LWitter/Arduino_Nanoject/IMG_2895.jpeg

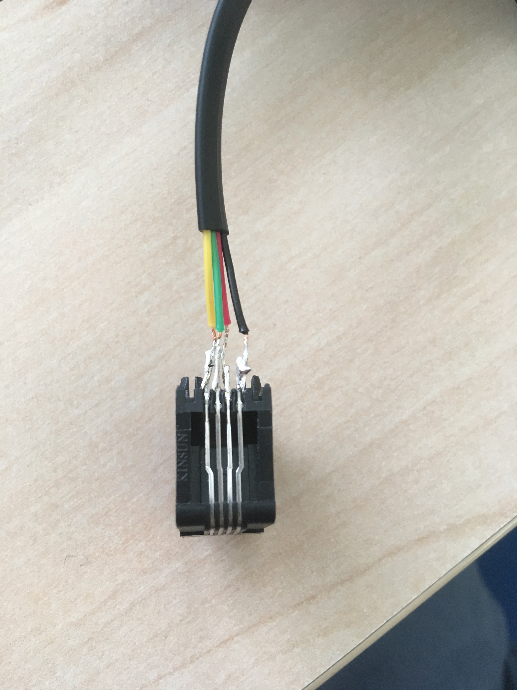
IMG_2895.jpeg
