LWitter/Arduino_Nanoject/IMG_2896.jpeg

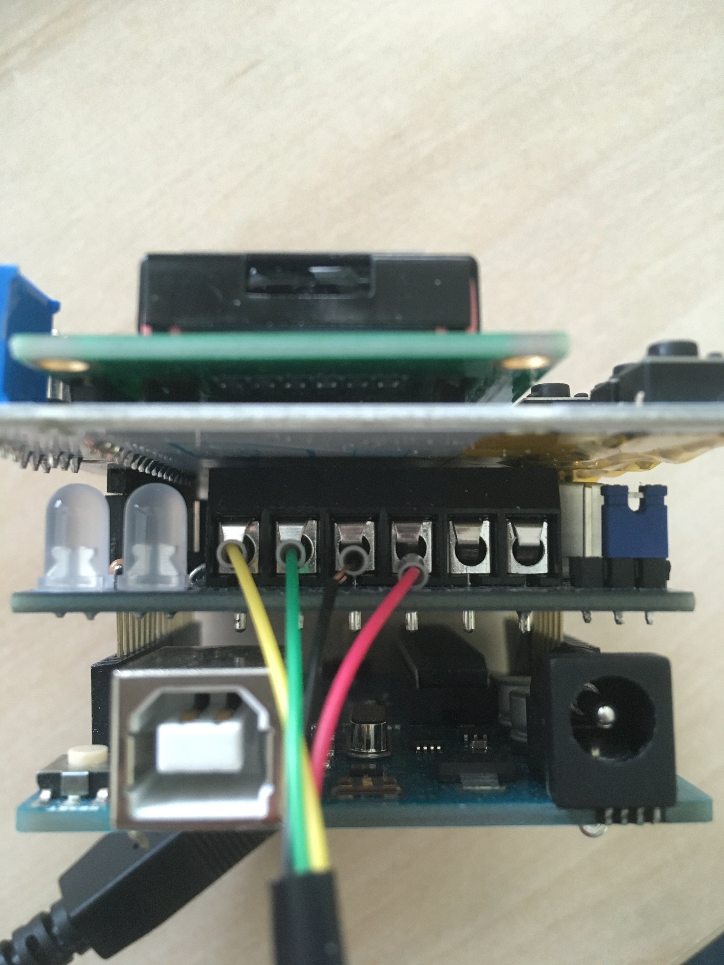
IMG_2896.jpeg
